denis4net/netdroid/README.md

netdroid
========

NetDroid project:
	NetDroid is neuraxis for RC robot.
