denis4net/netdroid/images/neuraxis_pwm.png

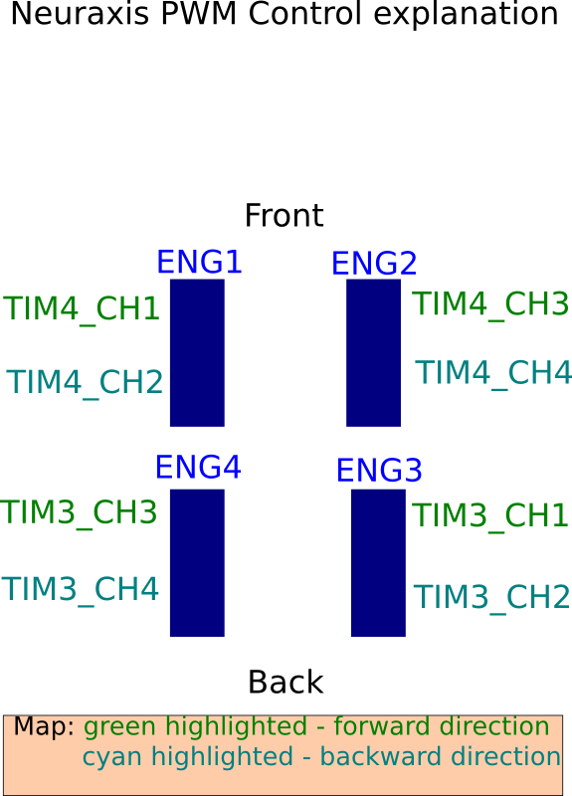
images/neuraxis_pwm.png
