denis4net/netdroid/newschem/netdroid.kicad_pcb

## KiCad design newschem/netdroid.kicad_pcb (2013-11-22)

Schematic: netdroid.sch, WebDroid Neuraxis

Parts:
8MHz1: CRYSTAL
ADC1, ADC2: CONN_2
C1, C4, C5, C6, C7: 100nF
C2, C3: 20pF
C9: 1uF
D11, D12, D13, D14, D21, D22, D23, D24, D31, D32, D33, D34, D41, D42, D43, D44: DIODE
ENG1, ENG2, ENG3, ENG4: engpin
JP_BOOT0, JP_BOOT1: BREAKER
KEY1, KEY2, KEY3, KEY4: IR4426
LED1, LED2: LED
P1, P2, P3, P4, P5, P6, P7, P8: CONN_1
PSWD1: CONN_2
PWR1: CONN_2
PWR2: CONN_3
R1: 330
R2, R3: 10k
R4, R5: 510
R6, R7: R
SERVO1: CONN_4
U1: STM32F100C4; LQFP48
USART1, USART2: CONN_2
reset1: SW_PUSH

Connections:
+12V: D11.2 (K), D13.2 (K), D21.2 (K), D23.2 (K), D31.2 (K), D33.2 (K), D41.2 (K), D43.2 (K), KEY1.6 (Vs), KEY2.6 (Vs), KEY3.6 (Vs), KEY4.6 (Vs), P6.1, P7.1, PWR2.3
unnamed: KEY2.4 (INB), U1.42 (PB6/I2C1_SCL/TIM16_CH1N)
unnamed: KEY1.4 (INB), U1.45 (PB8/TIM4_CH3/TIM16_CH1/CEC)
unnamed: KEY1.2 (INA), U1.46 (PB9/TIM4_CH4/TIM17_CH1)
unnamed: JP_BOOT1.1, R3.1, U1.20 (PB2/BOOT1)
unnamed: KEY4.2 (INA), U1.17 (SPI1_MOSI/ADC1_IN7/TIM3_CH2/PA7)
unnamed: KEY4.4 (INB), U1.16 (SPI1_MISO/ADC1_IN6/TIM3_CH1/PA6)
unnamed: C1.1, R1.1, U1.7 (~NRST), reset1.2
unnamed: JP_BOOT0.1, R2.1, U1.44 (BOOT0)
unnamed: SERVO1.1, U1.28 (PB15/TIM1_CH3N/TIM15_CH1N)
unnamed: SERVO1.4, U1.25 (PB12/TIM1_BKIN)
unnamed: SERVO1.3, U1.26 (PB13/TIM1_CH1N)
unnamed: SERVO1.2, U1.27 (PB14/TIM1_CH2N)
unnamed: U1.13 (USART2_RX/ADC1_IN3/TIM2_CH4/TIM15_CH2/P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), USART2.2 (PM)
unnamed: U1.12 (USART2_TX/ADC1_IN2/TIM2_CH3/TIM15_CH1/P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), USART2.1
unnamed: KEY3.4 (INB), U1.18 (PB0/ADC1_IN8/TIM3_CH3)
unnamed: KEY3.2 (INA), U1.19 (PB1/ADC1_IN9/TIM3_CH4)
unnamed: ADC1.2 (PM), U1.10 (WKUP/USART2_CTS/ADC1_IN0/TIM2_CH1_ETR/P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)
unnamed: ADC2.2 (PM), U1.11 (USART2_RTS/ADC1_IN1/TIM2_CH2/PA1)
unnamed: KEY2.2 (INA), U1.43 (PB7/I2C1_SDA/TIM17_CH1N)
unnamed: PSWD1.2 (PM), U1.37 (JTCK/SWCLK/PA14)
unnamed: U1.31 (USART1_RX/TIM1_CH3/TIM17_BKIN/PA10), USART1.2 (PM)
unnamed: U1.30 (USART1_TX/TIM1_CH2/TIM15_BKIN/PA9), USART1.1
unnamed: PSWD1.1, U1.34 (JTMS/SWDIO/PA13)
unnamed: R7.1, U1.41 (PB5/I2C1_SMBA/TIM16_BKIN)
unnamed: JP_BOOT0.2, R4.1
unnamed: JP_BOOT1.2, R5.1
unnamed: 8MHz1.2, C3.2, U1.6 (OSC_OUT)
unnamed: D43.1 (A), D44.2 (K), ENG4.2 (PM), KEY4.5 (OUTB)
unnamed: D11.1 (A), D12.2 (K), ENG1.1, KEY1.7 (OUTA)
unnamed: D13.1 (A), D14.2 (K), ENG1.2 (PM), KEY1.5 (OUTB)
unnamed: D41.1 (A), D42.2 (K), ENG4.1, KEY4.7 (OUTA)
unnamed: LED1.1 (A), R6.2
unnamed: D21.1 (A), D22.2 (K), ENG2.1, KEY2.7 (OUTA)
unnamed: D23.1 (A), D24.2 (K), ENG2.2 (PM), KEY2.5 (OUTB)
unnamed: D31.1 (A), D32.2 (K), ENG3.1, KEY3.7 (OUTA)
unnamed: 8MHz1.1, C2.1, U1.5 (OSC_IN)
unnamed: D33.1 (A), D34.2 (K), ENG3.2 (PM), KEY3.5 (OUTB)
unnamed: LED2.1 (A), R7.2
VDD: C4.2, C5.2, C6.2, C7.2, C9.2, P1.1, P2.1, P3.1, P4.1, P5.1, PWR1.2 (PM), PWR2.2 (PM), R1.2, R2.2, R3.2, R6.1, U1.9 (VDDA), U1.24 (VDD), U1.36 (VDD), U1.48 (VDD), reset1.1
VSS: ADC1.1, ADC2.1, C1.2, C2.2, C3.1, C4.1, C5.1, C6.1, C7.1, C9.1, D12.1 (A), D14.1 (A), D22.1 (A), D24.1 (A), D32.1 (A), D34.1 (A), D42.1 (A), D44.1 (A), KEY1.3 (GND), KEY2.3 (GND), KEY3.3 (GND), KEY4.3 (GND), LED1.2 (K), LED2.2 (K), P8.1, PWR1.1, PWR2.1, R4.2, R5.2, U1.8 (VSSA), U1.23 (VSS), U1.35 (VSS), U1.47 (VSS)

Notes on the sheet:
service\dbg 115200 8N1 uart

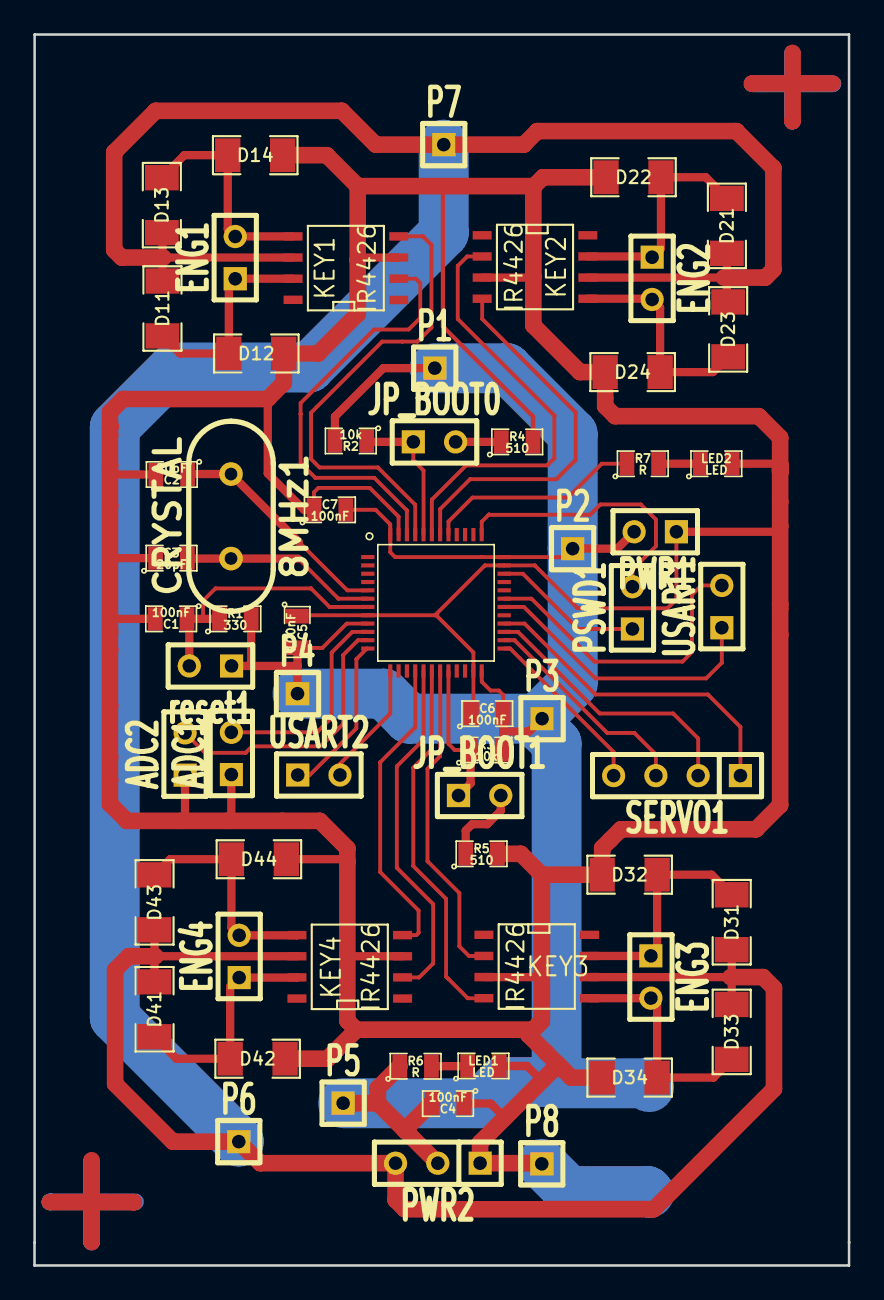
[picture p2: board netdroid.kicad_pcb from above]

Board: 2 copper layers, 49.0 x 74.0 mm, 62 parts (1 on the bottom side), 41 nets.
