denis4net/netdroid/(commit log)

2013-09-27 Shell skeleton. UART1->UART2
2013-09-28 Schem improved: 4 engines, 2 servo out added
    [test.kicad_pcb, test.sch]
2013-09-29 Keys added
    [test.sch]
2013-10-22 Переделана заново схема, исправлена куча ошибок
    [netdroid.kicad_pcb, netdroid.sch, test.dsn, test.kicad_pcb]
2013-11-07 почти нарисовал схкму. Не нашел переходные отверстия. Заебало.
    [netdroid.kicad_pcb, netdroid.sch]
2013-11-09 Moving to Eclipse. STD lib and argument parsing added
    [test.dsn, test.kicad_pcb, test.sch]
2013-11-11 захуярил схему
    [netdroid.kicad_pcb, netdroid.sch]
2013-11-12 вроде все
    [netdroid.kicad_pcb]
2013-11-14 PWM Fixies
2013-11-16 Надеюсь, это финальная версия
    [netdroid.kicad_pcb]
2013-11-20 заел на будущее
    [netdroid.kicad_pcb, netdroid.sch]
2013-12-01 PWM init/control implemented
    [netdroid.sch]
2014-03-15 UART Shell bug fixed
    [cmd.c, cmd.h, enginectl.c, led.c, main.c, queue.c, shell.c]
2014-03-15 Repo ranked
    [netdroid.sch]
